0xEBD/fumeXsense/pocs/esp32/evolving_skeleton_poc/001_hello_wx2/assets/fxs_p003_esp32c3.jpg

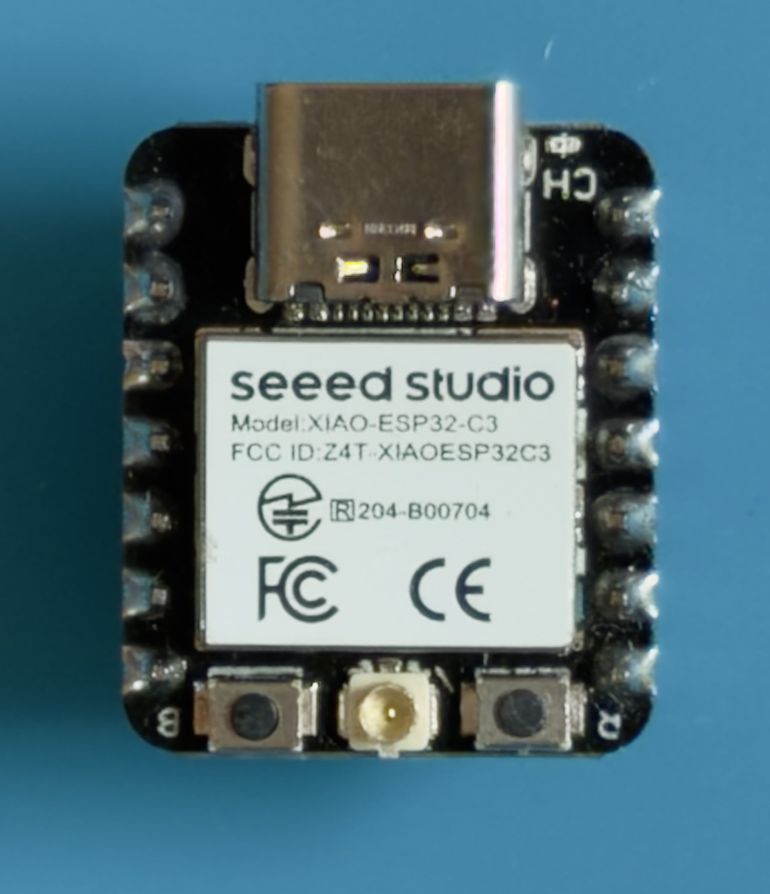
pocs/esp32/evolving_skeleton_poc/001_hello_wx2/assets/fxs_p003_esp32c3.jpg
