0xEBD/fumeXsense/pocs/esp32/evolving_skeleton_poc/002_oled_hmi/assets/fumex_spark_right_exact.png

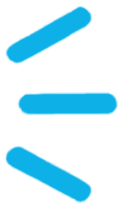
pocs/esp32/evolving_skeleton_poc/002_oled_hmi/assets/fumex_spark_right_exact.png
