0xEBD/fumeXsense/pocs/esp32/evolving_skeleton_poc/002_oled_hmi/assets/fxs_p004_b1_case.jpg

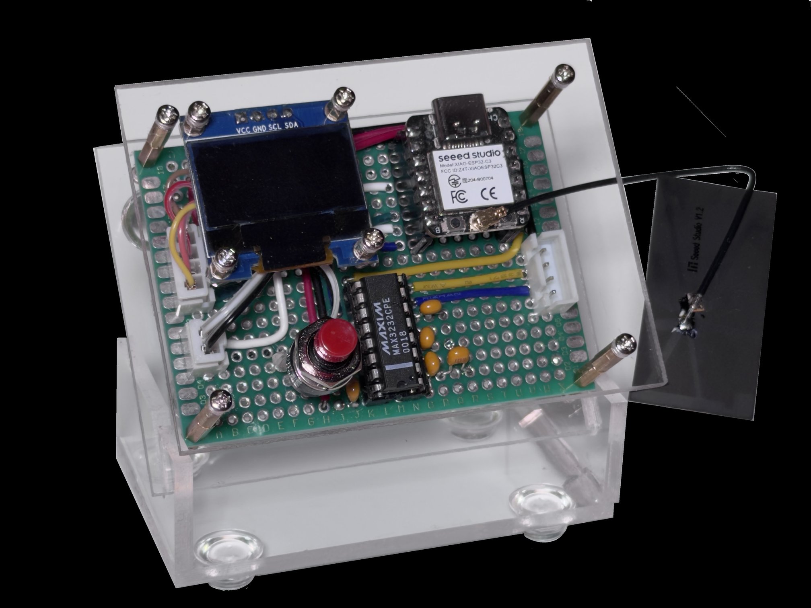
pocs/esp32/evolving_skeleton_poc/002_oled_hmi/assets/fxs_p004_b1_case.jpg
