0xEBD/fumeXsense/pocs/esp32/evolving_skeleton_poc/002_oled_hmi/assets/fxs_p004_oled_hmi_overview.png

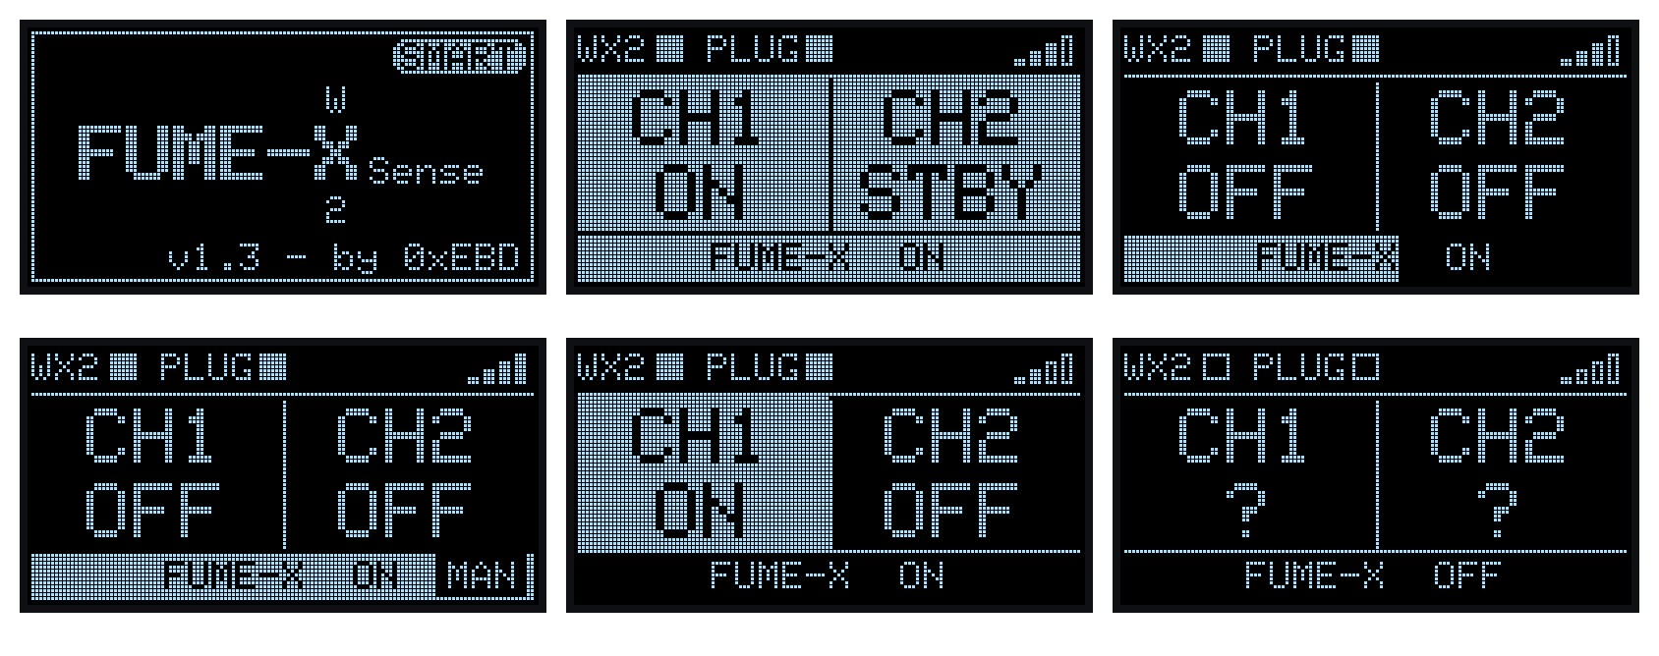
pocs/esp32/evolving_skeleton_poc/002_oled_hmi/assets/fxs_p004_oled_hmi_overview.png
