0xEBD/fumeXsense/pocs/esp32/evolving_skeleton_poc/002_oled_hmi/assets/post004_fxs_slide.png

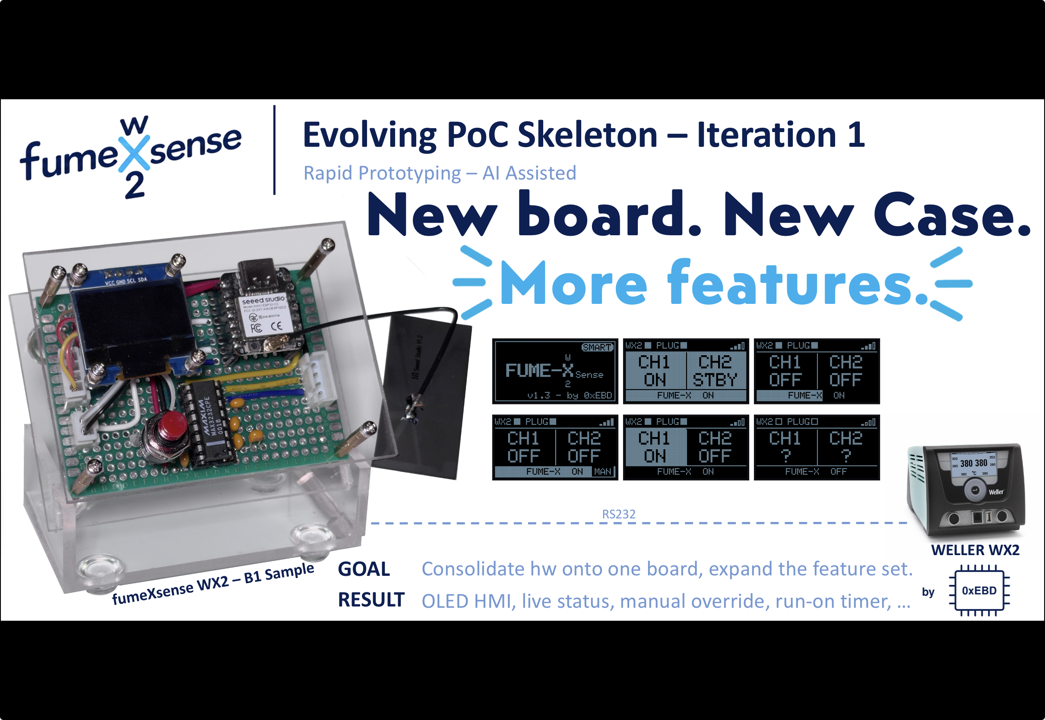
pocs/esp32/evolving_skeleton_poc/002_oled_hmi/assets/post004_fxs_slide.png
