0xEBD/fumeXsense/pocs/pc_tool/assets/fxs_p002_bb_back.jpg

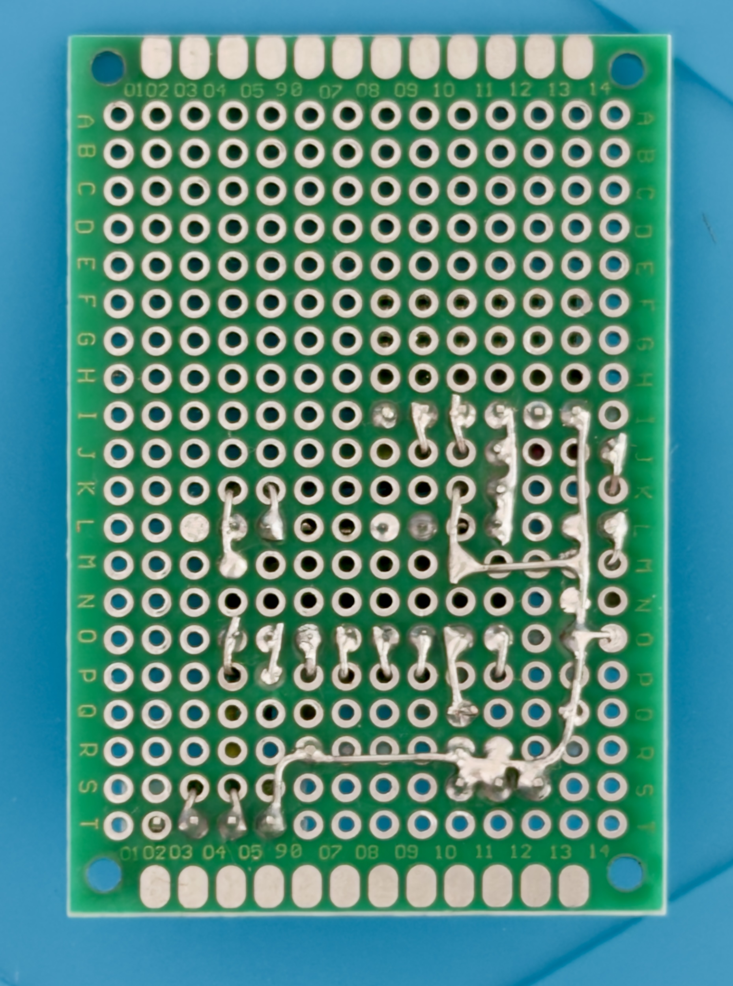
pocs/pc_tool/assets/fxs_p002_bb_back.jpg
